shining-man/bsc_extension_serial/README.md

# Serial port extension for the BSC
This extension adds 8 additional serial ports to the Battery safety controller (BSC). This allows a total of 11 serial devices to be connected to the BSC.

The BSC is connected to this extension via an 8-pin bus cable.
