shining-man/bsc_extension_serial/circuit.pdf

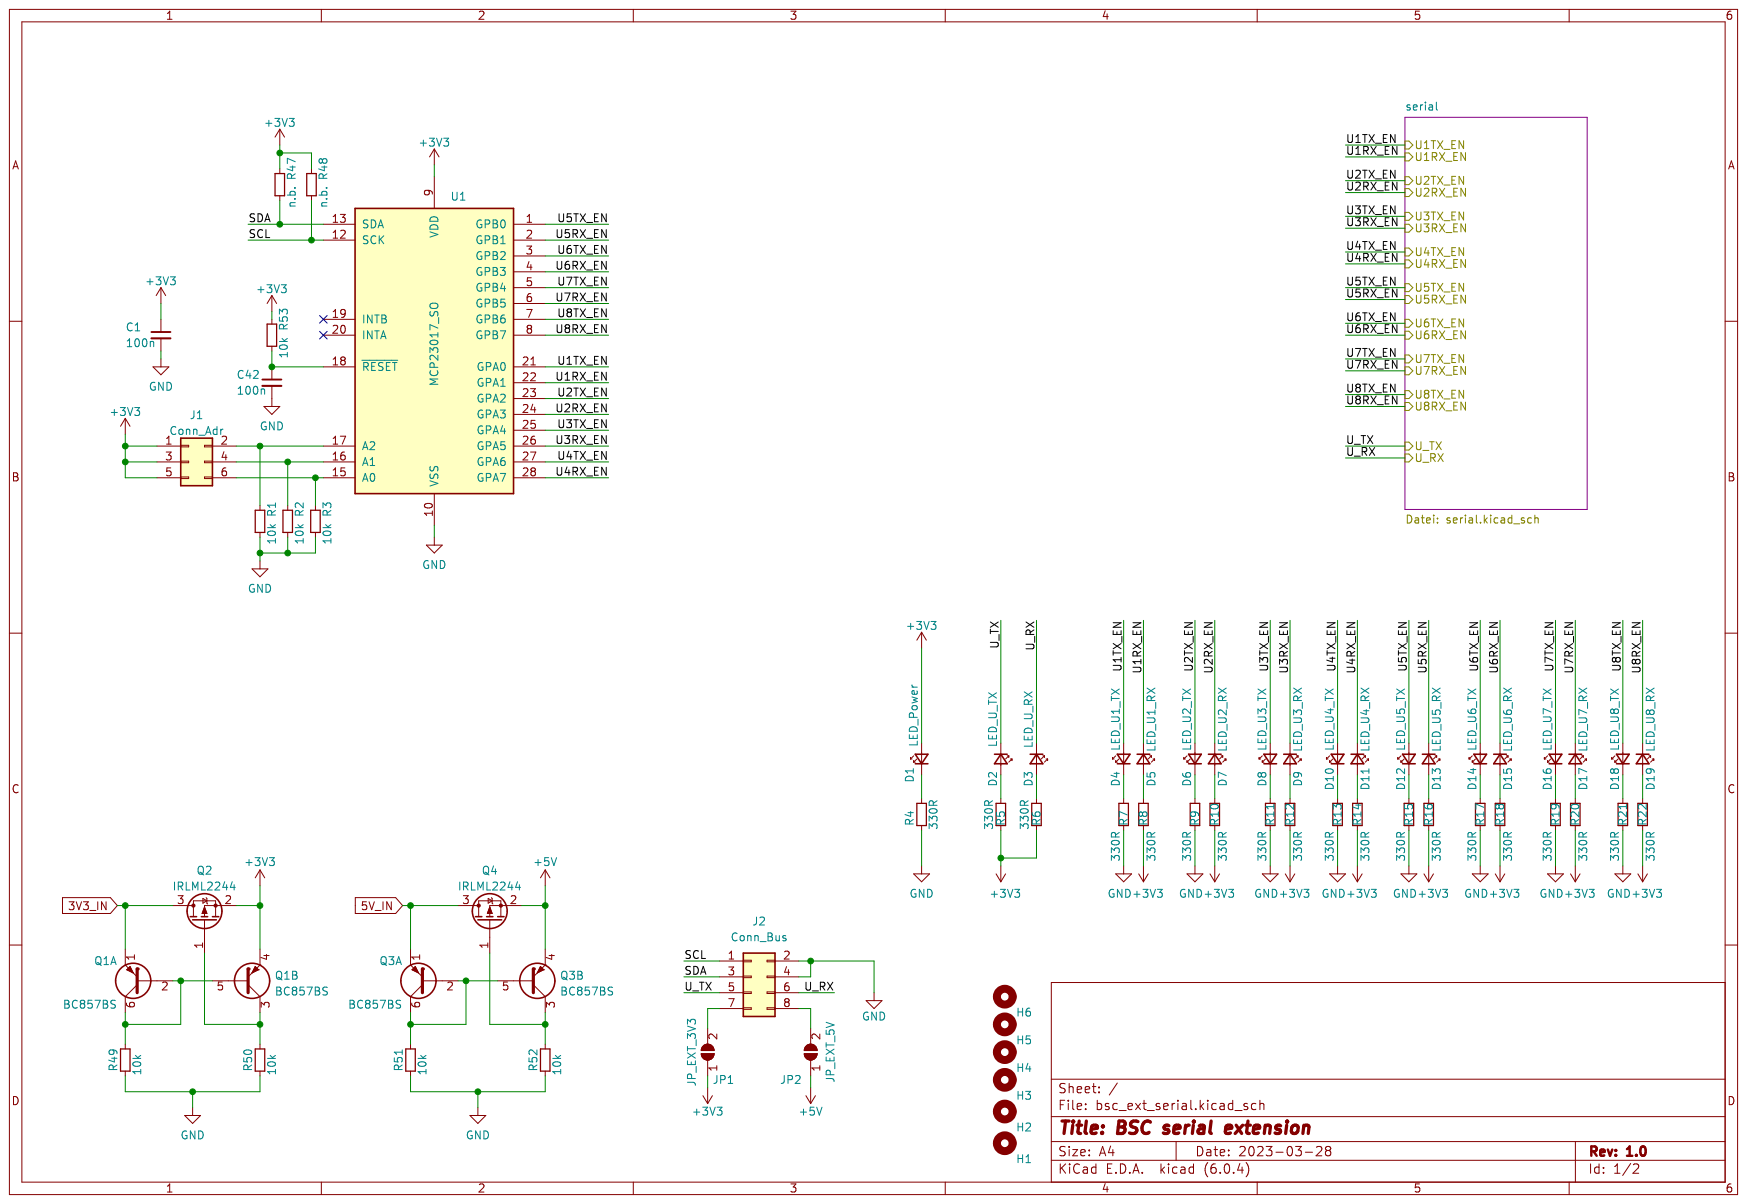
[picture p1: page 1]

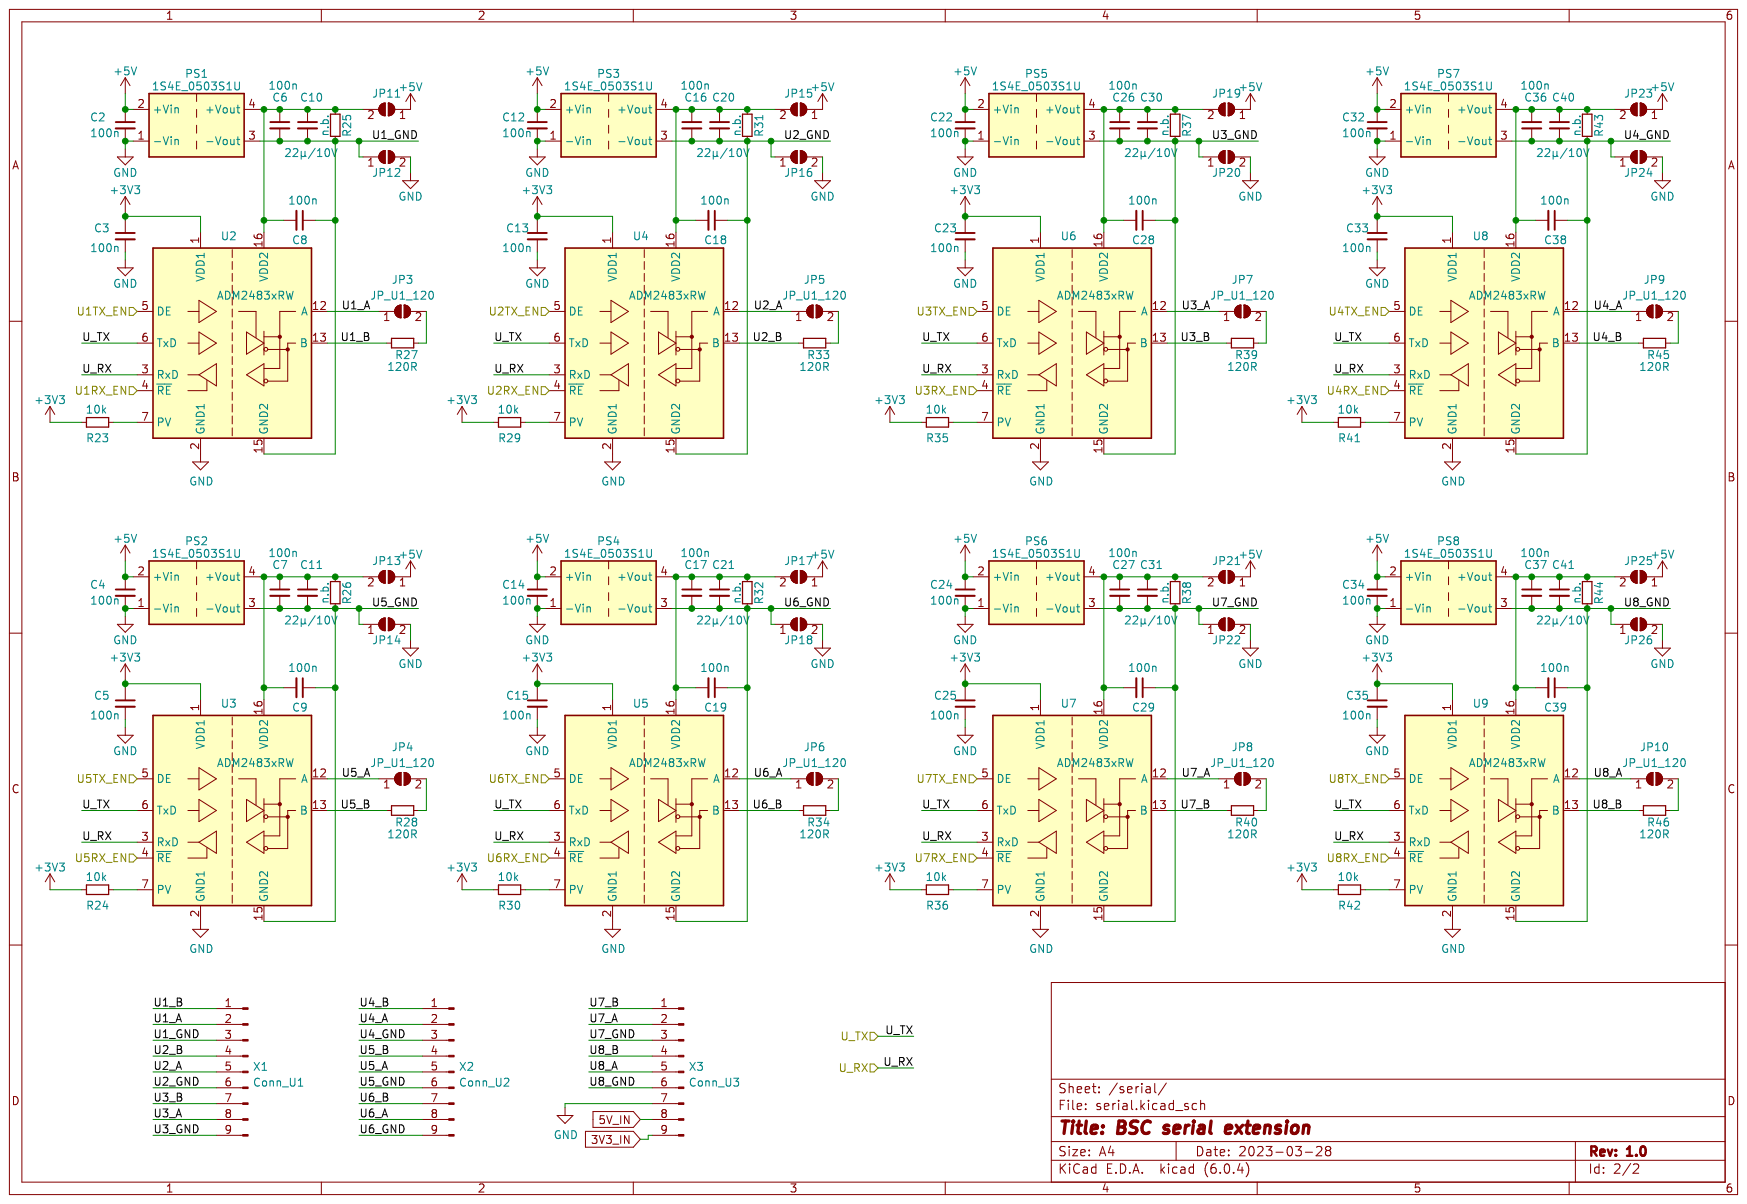
[picture p2: page 2]
