shining-man/bsc_extension_serial/bsc_ext_serial.kicad_pcb

## KiCad design bsc_ext_serial.kicad_pcb (2023-04-03)

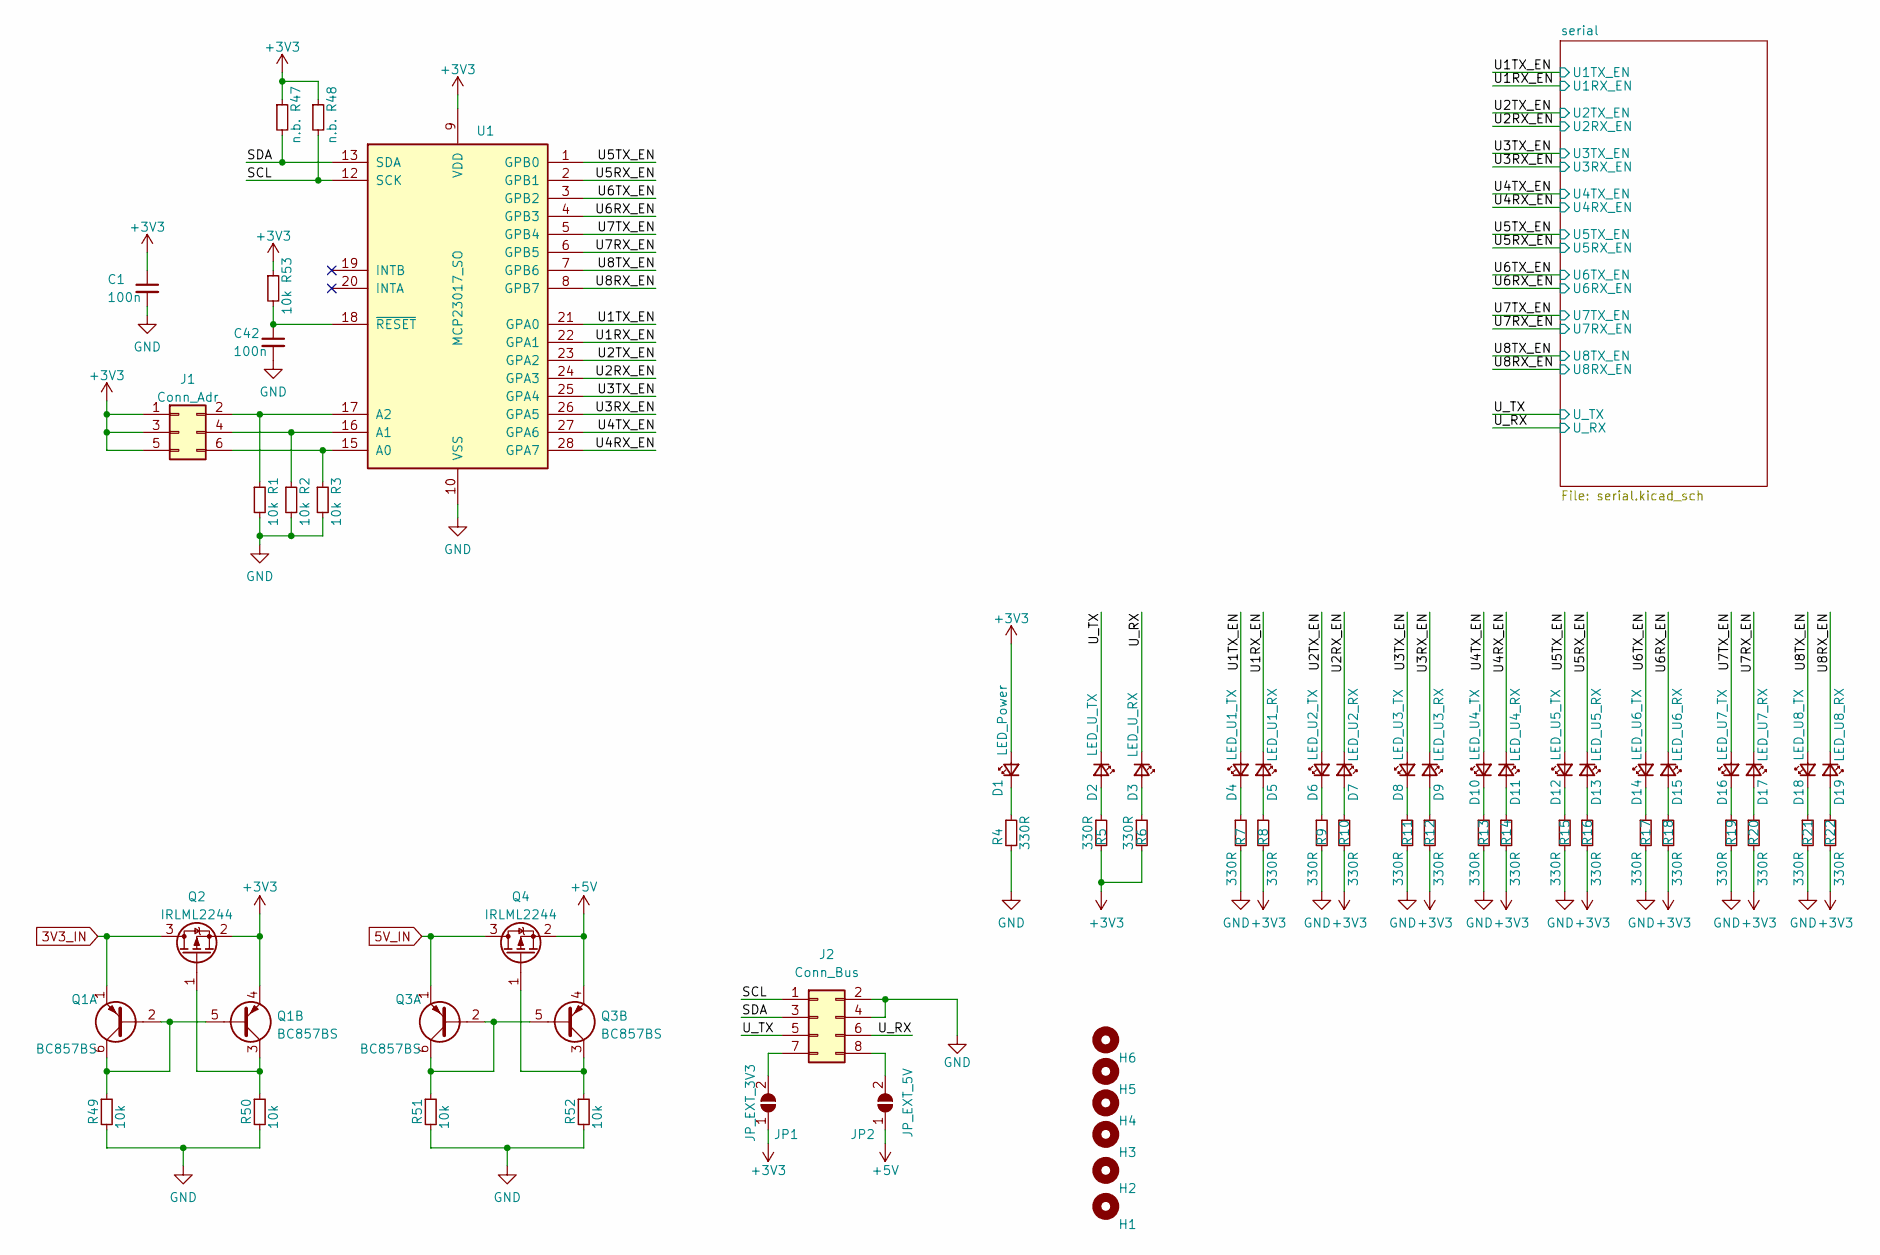
[picture p3: schematic bsc_ext_serial.kicad_sch, BSC serial extension]

Parts:
C1, C42: 100n; C_0603_1608Metric
D1: LED_Power; LED_0603_1608Metric
D2: LED_U_TX; LED_0603_1608Metric
D3: LED_U_RX; LED_0603_1608Metric
D4: LED_U1_TX; LED_0603_1608Metric
D5: LED_U1_RX; LED_0603_1608Metric
D6: LED_U2_TX; LED_0603_1608Metric
D7: LED_U2_RX; LED_0603_1608Metric
D8: LED_U3_TX; LED_0603_1608Metric
D9: LED_U3_RX; LED_0603_1608Metric
D10: LED_U4_TX; LED_0603_1608Metric
D11: LED_U4_RX; LED_0603_1608Metric
D12: LED_U5_TX; LED_0603_1608Metric
D13: LED_U5_RX; LED_0603_1608Metric
D14: LED_U6_TX; LED_0603_1608Metric
D15: LED_U6_RX; LED_0603_1608Metric
D16: LED_U7_TX; LED_0603_1608Metric
D17: LED_U7_RX; LED_0603_1608Metric
D18: LED_U8_TX; LED_0603_1608Metric
D19: LED_U8_RX; LED_0603_1608Metric
H1, H2, H3, H4, H5, H6: MountingHole; MountingHole_3.2mm_M3
J1: Conn_Adr; PinHeader_2x03_P2.54mm_Vertical
J2: Conn_Bus; PinHeader_2x04_P2.54mm_Vertical
JP1: JP_EXT_3V3; SolderJumper-2_P1.3mm_Open_RoundedPad1.0x1.5mm
JP2: JP_EXT_5V; SolderJumper-2_P1.3mm_Open_RoundedPad1.0x1.5mm
Q1, Q3: BC857BS; SOT-363_SC-70-6
Q2, Q4: IRLML2244; SOT-23
R1, R2, R3, R49, R50, R51, R52, R53: 10k; R_0603_1608Metric
R4, R5, R6, R7, R8, R9, R10, R11, R12, R13, R14, R15, R16, R17, R18, R19, R20, R21, R22: 330R; R_0603_1608Metric
R47, R48: n.b.; R_0603_1608Metric
U1: MCP23017_SO; SOIC-28W_7.5x17.9mm_P1.27mm

Connections:
3V3_IN: Q1.1 (E1), Q2.3 (D); also elsewhere on the board
5V_IN: Q3.1 (E1), Q4.3 (D); also elsewhere on the board
+3V3: C1.1, D1.2 (A), J1.1, J1.3, J1.5, JP1.1 (A), Q1.4 (E2), Q2.2 (S), R5.2, R6.2, R8.2, R10.2, R12.2, R14.2, R16.2, R18.2, R20.2, R22.2, R47.1, R48.1, R53.1, U1.9 (VDD); also elsewhere on the board
+5V: JP2.1 (A), Q3.4 (E2), Q4.2 (S); also elsewhere on the board
/SCL: J2.1, R48.2, U1.12 (SCK)
/SDA: J2.3, R47.2, U1.13 (SDA)
/U1RX_EN: D5.1 (K), U1.22 (GPA1); also elsewhere on the board
/U1TX_EN: D4.2 (A), U1.21 (GPA0); also elsewhere on the board
/U2RX_EN: D7.1 (K), U1.24 (GPA3); also elsewhere on the board
/U2TX_EN: D6.2 (A), U1.23 (GPA2); also elsewhere on the board
/U3RX_EN: D9.1 (K), U1.26 (GPA5); also elsewhere on the board
/U3TX_EN: D8.2 (A), U1.25 (GPA4); also elsewhere on the board
/U4RX_EN: D11.1 (K), U1.28 (GPA7); also elsewhere on the board
/U4TX_EN: D10.2 (A), U1.27 (GPA6); also elsewhere on the board
/U5RX_EN: D13.1 (K), U1.2 (GPB1); also elsewhere on the board
/U5TX_EN: D12.2 (A), U1.1 (GPB0); also elsewhere on the board
/U6RX_EN: D15.1 (K), U1.4 (GPB3); also elsewhere on the board
/U6TX_EN: D14.2 (A), U1.3 (GPB2); also elsewhere on the board
/U7RX_EN: D17.1 (K), U1.6 (GPB5); also elsewhere on the board
/U7TX_EN: D16.2 (A), U1.5 (GPB4); also elsewhere on the board
/U8RX_EN: D19.1 (K), U1.8 (GPB7); also elsewhere on the board
/U8TX_EN: D18.2 (A), U1.7 (GPB6); also elsewhere on the board
/U_RX: D3.1 (K), J2.6; also elsewhere on the board
/U_TX: D2.1 (K), J2.5; also elsewhere on the board
GND: C1.2, C42.2, J2.2, J2.4, R1.2, R2.2, R3.2, R4.2, R7.2, R9.2, R11.2, R13.2, R15.2, R17.2, R19.2, R21.2, R49.2, R50.2, R51.2, R52.2, U1.10 (VSS); also elsewhere on the board
unnamed: C42.1, R53.2, U1.18 (~RESET)
unnamed: D1.1 (K), R4.1
unnamed: D2.2 (A), R5.1
unnamed: D3.2 (A), R6.1
unnamed: D4.1 (K), R7.1
unnamed: D5.2 (A), R8.1
unnamed: D6.1 (K), R9.1
unnamed: D7.2 (A), R10.1
unnamed: D8.1 (K), R11.1
unnamed: D9.2 (A), R12.1
unnamed: D10.1 (K), R13.1
unnamed: D11.2 (A), R14.1
unnamed: D12.1 (K), R15.1
unnamed: D13.2 (A), R16.1
unnamed: D14.1 (K), R17.1
unnamed: D15.2 (A), R18.1
unnamed: D16.1 (K), R19.1
unnamed: D17.2 (A), R20.1
unnamed: D18.1 (K), R21.1
unnamed: D19.2 (A), R22.1
unnamed: J1.2, R1.1, U1.17 (A2)
unnamed: J1.4, R2.1, U1.16 (A1)
unnamed: J1.6, R3.1, U1.15 (A0)
unnamed: J2.7, JP1.2 (B)
unnamed: J2.8, JP2.2 (B)
unnamed: Q1.2 (B1), Q1.5 (B2), Q1.6 (C1), R49.1
unnamed: Q1.3 (C2), Q2.1 (G), R50.1
unnamed: Q3.2 (B1), Q3.5 (B2), Q3.6 (C1), R51.1
unnamed: Q3.3 (C2), Q4.1 (G), R52.1

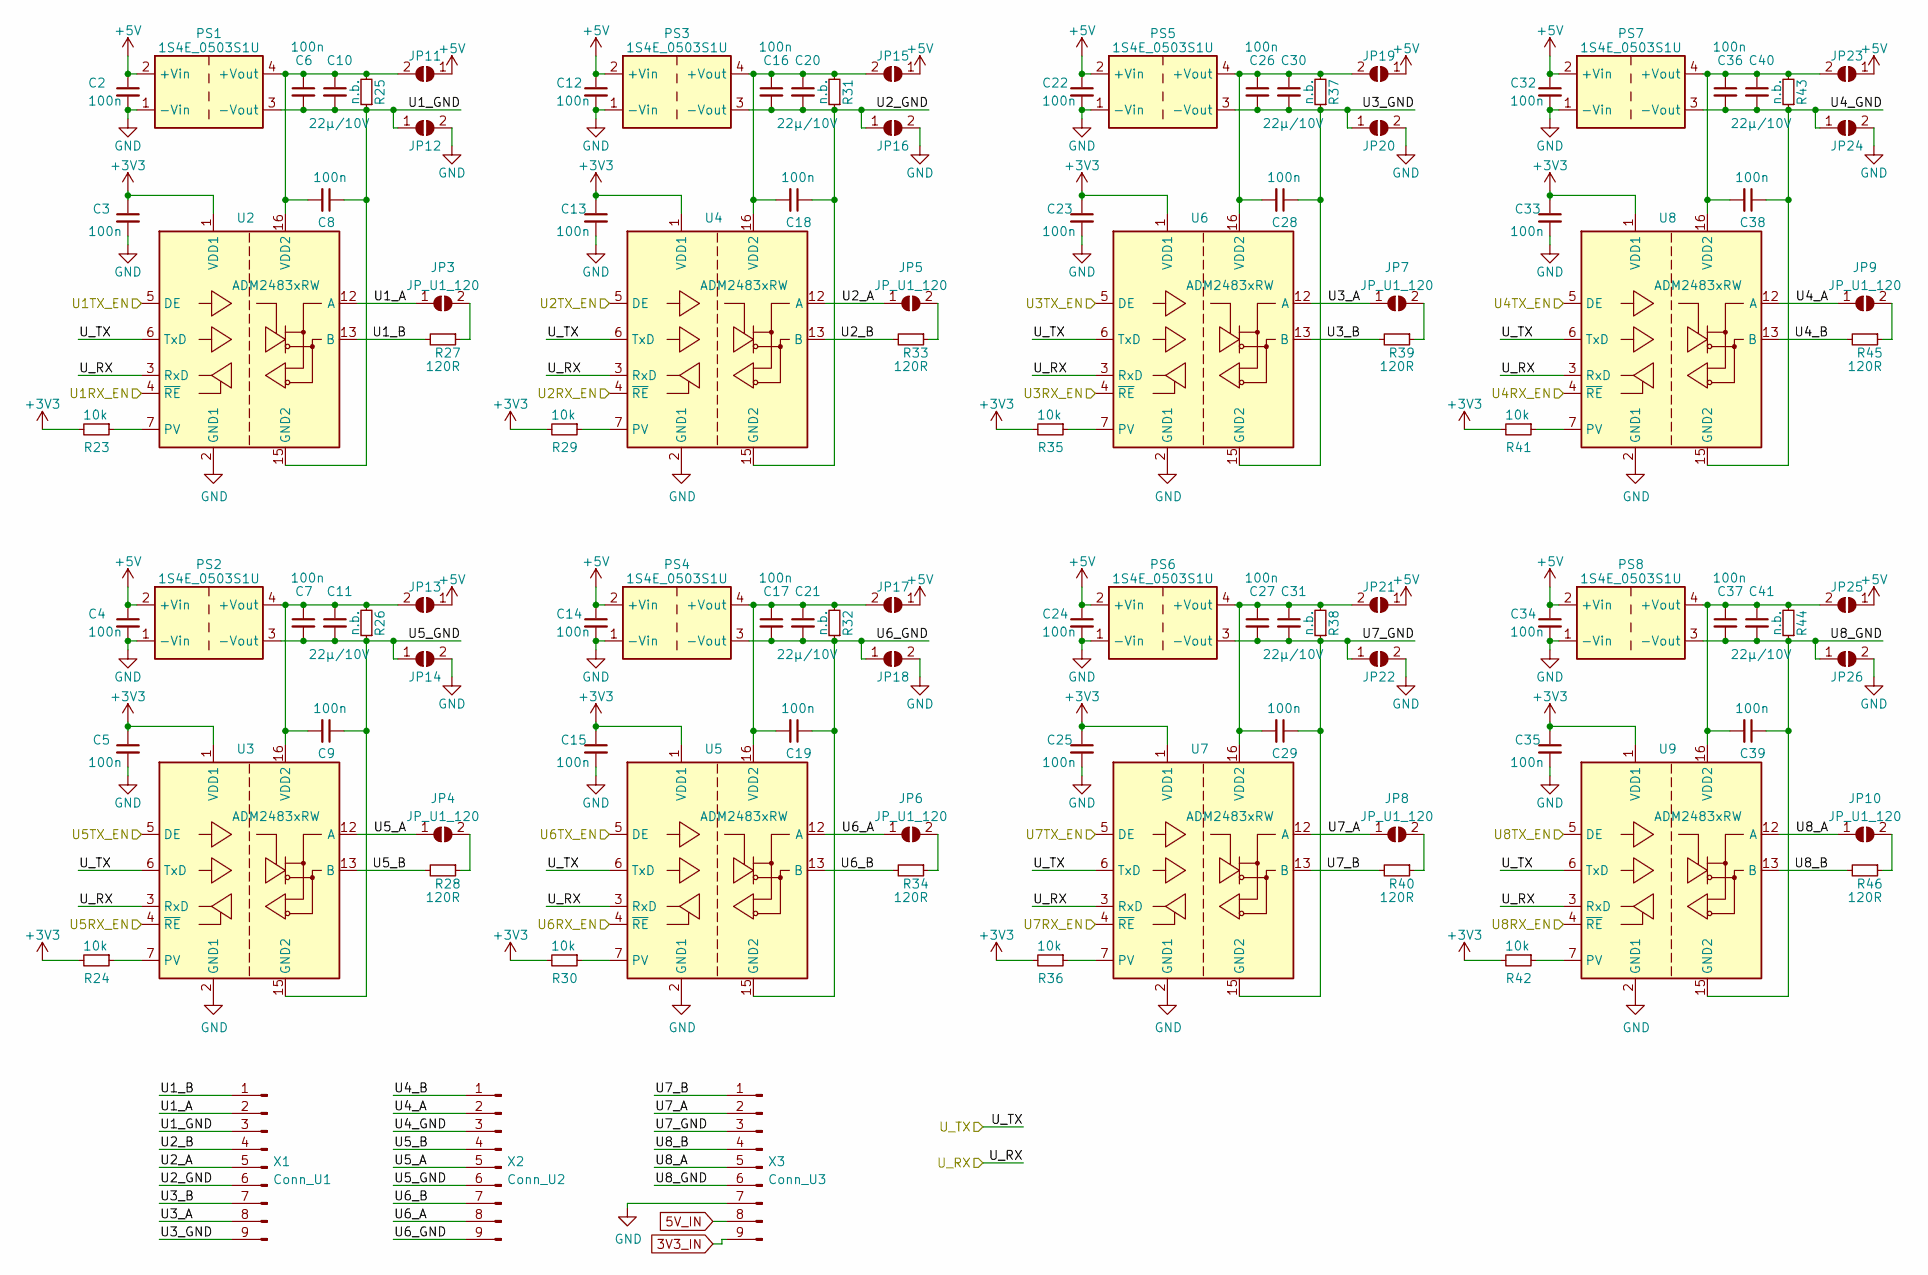
[picture p4: schematic serial.kicad_sch, BSC serial extension]

Parts:
C2, C3, C4, C5, C6, C7, C8, C9, C12, C13, C14, C15, C16, C17, C18, C19, C22, C23, C24, C25, C26, C27, C28, C29, C32, C33, C34, C35, C36, C37, C38, C39: 100n; C_0603_1608Metric
C10, C11, C20, C21, C30, C31, C40, C41: 22µ/10V; C_1206_3216Metric
JP3, JP4, JP5, JP6, JP7, JP8, JP9, JP10: JP_U1_120; SolderJumper-2_P1.3mm_Open_Pad1.0x1.5mm
JP11, JP12, JP13, JP14, JP15, JP16, JP17, JP18, JP19, JP20, JP21, JP22, JP23, JP24, JP25, JP26: SolderJumper-2_P1.3mm_Open_RoundedPad1.0x1.5mm
PS1, PS2, PS3, PS4, PS5, PS6, PS7, PS8: 1S4E_0503S1U; Converter_DCDC_GAPTEC_1S4E_S1U
R23, R24, R29, R30, R35, R36, R41, R42: 10k; R_0603_1608Metric
R25, R26, R31, R32, R37, R38, R43, R44: n.b.; R_0603_1608Metric
R27, R28, R33, R34, R39, R40, R45, R46: 120R; R_0603_1608Metric
U2, U3, U4, U5, U6, U7, U8, U9: ADM2483xRW; SOIC-16W_7.5x10.3mm_P1.27mm; PartNumber ADM2483BRWZ-REEL; LCSCStockCode C9637
X1: Conn_U1; PhoenixContact_MCV_1,5_9-G-3.81_1x09_P3.81mm_Vertical
X2: Conn_U2; PhoenixContact_MCV_1,5_9-G-3.81_1x09_P3.81mm_Vertical
X3: Conn_U3; PhoenixContact_MCV_1,5_9-G-3.81_1x09_P3.81mm_Vertical

Connections:
3V3_IN: X3.9; also elsewhere on the board
5V_IN: X3.8; also elsewhere on the board
+3V3: C3.1, C5.1, C13.1, C15.1, C23.1, C25.1, C33.1, C35.1, R23.2, R24.2, R29.2, R30.2, R35.2, R36.2, R41.2, R42.2, U2.1 (VDD1), U3.1 (VDD1), U4.1 (VDD1), U5.1 (VDD1), U6.1 (VDD1), U7.1 (VDD1), U8.1 (VDD1), U9.1 (VDD1); also elsewhere on the board
+5V: C2.1, C4.1, C12.1, C14.1, C22.1, C24.1, C32.1, C34.1, JP11.1 (A), JP13.1 (A), JP15.1 (A), JP17.1 (A), JP19.1 (A), JP21.1 (A), JP23.1 (A), JP25.1 (A), PS1.2 (+Vin), PS2.2 (+Vin), PS3.2 (+Vin), PS4.2 (+Vin), PS5.2 (+Vin), PS6.2 (+Vin), PS7.2 (+Vin), PS8.2 (+Vin); also elsewhere on the board
/U1RX_EN: U2.4 (~RE); also elsewhere on the board
/U1TX_EN: U2.5 (DE); also elsewhere on the board
/U2RX_EN: U4.4 (~RE); also elsewhere on the board
/U2TX_EN: U4.5 (DE); also elsewhere on the board
/U3RX_EN: U6.4 (~RE); also elsewhere on the board
/U3TX_EN: U6.5 (DE); also elsewhere on the board
/U4RX_EN: U8.4 (~RE); also elsewhere on the board
/U4TX_EN: U8.5 (DE); also elsewhere on the board
/U5RX_EN: U3.4 (~RE); also elsewhere on the board
/U5TX_EN: U3.5 (DE); also elsewhere on the board
/U6RX_EN: U5.4 (~RE); also elsewhere on the board
/U6TX_EN: U5.5 (DE); also elsewhere on the board
/U7RX_EN: U7.4 (~RE); also elsewhere on the board
/U7TX_EN: U7.5 (DE); also elsewhere on the board
/U8RX_EN: U9.4 (~RE); also elsewhere on the board
/U8TX_EN: U9.5 (DE); also elsewhere on the board
/U_RX: U2.3 (RxD), U3.3 (RxD), U4.3 (RxD), U5.3 (RxD), U6.3 (RxD), U7.3 (RxD), U8.3 (RxD), U9.3 (RxD); also elsewhere on the board
/U_TX: U2.6 (TxD), U3.6 (TxD), U4.6 (TxD), U5.6 (TxD), U6.6 (TxD), U7.6 (TxD), U8.6 (TxD), U9.6 (TxD); also elsewhere on the board
/serial/U1_A: JP3.1 (A), U2.12 (A), X1.2
/serial/U1_B: R27.2, U2.13 (B), X1.1
/serial/U1_GND: C6.2, C8.1, C10.2, JP12.1 (A), PS1.3 (-Vout), R25.1, U2.9 (GND2), U2.15 (GND2), X1.3
/serial/U2_A: JP5.1 (A), U4.12 (A), X1.5
/serial/U2_B: R33.2, U4.13 (B), X1.4
/serial/U2_GND: C16.2, C18.1, C20.2, JP16.1 (A), PS3.3 (-Vout), R31.1, U4.9 (GND2), U4.15 (GND2), X1.6
/serial/U3_A: JP7.1 (A), U6.12 (A), X1.8
/serial/U3_B: R39.2, U6.13 (B), X1.7
/serial/U3_GND: C26.2, C28.1, C30.2, JP20.1 (A), PS5.3 (-Vout), R37.1, U6.9 (GND2), U6.15 (GND2), X1.9
/serial/U4_A: JP9.1 (A), U8.12 (A), X2.2
/serial/U4_B: R45.2, U8.13 (B), X2.1
/serial/U4_GND: C36.2, C38.1, C40.2, JP24.1 (A), PS7.3 (-Vout), R43.1, U8.9 (GND2), U8.15 (GND2), X2.3
/serial/U5_A: JP4.1 (A), U3.12 (A), X2.5
/serial/U5_B: R28.2, U3.13 (B), X2.4
/serial/U5_GND: C7.2, C9.1, C11.2, JP14.1 (A), PS2.3 (-Vout), R26.1, U3.9 (GND2), U3.15 (GND2), X2.6
/serial/U6_A: JP6.1 (A), U5.12 (A), X2.8
/serial/U6_B: R34.2, U5.13 (B), X2.7
/serial/U6_GND: C17.2, C19.1, C21.2, JP18.1 (A), PS4.3 (-Vout), R32.1, U5.9 (GND2), U5.15 (GND2), X2.9
/serial/U7_A: JP8.1 (A), U7.12 (A), X3.2
/serial/U7_B: R40.2, U7.13 (B), X3.1
/serial/U7_GND: C27.2, C29.1, C31.2, JP22.1 (A), PS6.3 (-Vout), R38.1, U7.9 (GND2), U7.15 (GND2), X3.3
/serial/U8_A: JP10.1 (A), U9.12 (A), X3.5
/serial/U8_B: R46.2, U9.13 (B), X3.4
/serial/U8_GND: C37.2, C39.1, C41.2, JP26.1 (A), PS8.3 (-Vout), R44.1, U9.9 (GND2), U9.15 (GND2), X3.6
GND: C2.2, C3.2, C4.2, C5.2, C12.2, C13.2, C14.2, C15.2, C22.2, C23.2, C24.2, C25.2, C32.2, C33.2, C34.2, C35.2, JP12.2 (B), JP14.2 (B), JP16.2 (B), JP18.2 (B), JP20.2 (B), JP22.2 (B), JP24.2 (B), JP26.2 (B), PS1.1 (-Vin), PS2.1 (-Vin), PS3.1 (-Vin), PS4.1 (-Vin), PS5.1 (-Vin), PS6.1 (-Vin), PS7.1 (-Vin), PS8.1 (-Vin), U2.2 (GND1), U2.8 (GND1), U3.2 (GND1), U3.8 (GND1), U4.2 (GND1), U4.8 (GND1), U5.2 (GND1), U5.8 (GND1), U6.2 (GND1), U6.8 (GND1), U7.2 (GND1), U7.8 (GND1), U8.2 (GND1), U8.8 (GND1), U9.2 (GND1), U9.8 (GND1), X3.7; also elsewhere on the board
unnamed: C6.1, C8.2, C10.1, JP11.2 (B), PS1.4 (+Vout), R25.2, U2.16 (VDD2)
unnamed: C7.1, C9.2, C11.1, JP13.2 (B), PS2.4 (+Vout), R26.2, U3.16 (VDD2)
unnamed: C16.1, C18.2, C20.1, JP15.2 (B), PS3.4 (+Vout), R31.2, U4.16 (VDD2)
unnamed: C17.1, C19.2, C21.1, JP17.2 (B), PS4.4 (+Vout), R32.2, U5.16 (VDD2)
unnamed: C26.1, C28.2, C30.1, JP19.2 (B), PS5.4 (+Vout), R37.2, U6.16 (VDD2)
unnamed: C27.1, C29.2, C31.1, JP21.2 (B), PS6.4 (+Vout), R38.2, U7.16 (VDD2)
unnamed: C36.1, C38.2, C40.1, JP23.2 (B), PS7.4 (+Vout), R43.2, U8.16 (VDD2)
unnamed: C37.1, C39.2, C41.1, JP25.2 (B), PS8.4 (+Vout), R44.2, U9.16 (VDD2)
unnamed: JP3.2 (B), R27.1
unnamed: JP4.2 (B), R28.1
unnamed: JP5.2 (B), R33.1
unnamed: JP6.2 (B), R34.1
unnamed: JP7.2 (B), R39.1
unnamed: JP8.2 (B), R40.1
unnamed: JP9.2 (B), R45.1
unnamed: JP10.2 (B), R46.1
unnamed: R23.1, U2.7 (PV)
unnamed: R24.1, U3.7 (PV)
unnamed: R29.1, U4.7 (PV)
unnamed: R30.1, U5.7 (PV)
unnamed: R35.1, U6.7 (PV)
unnamed: R36.1, U7.7 (PV)
unnamed: R41.1, U8.7 (PV)
unnamed: R42.1, U9.7 (PV)

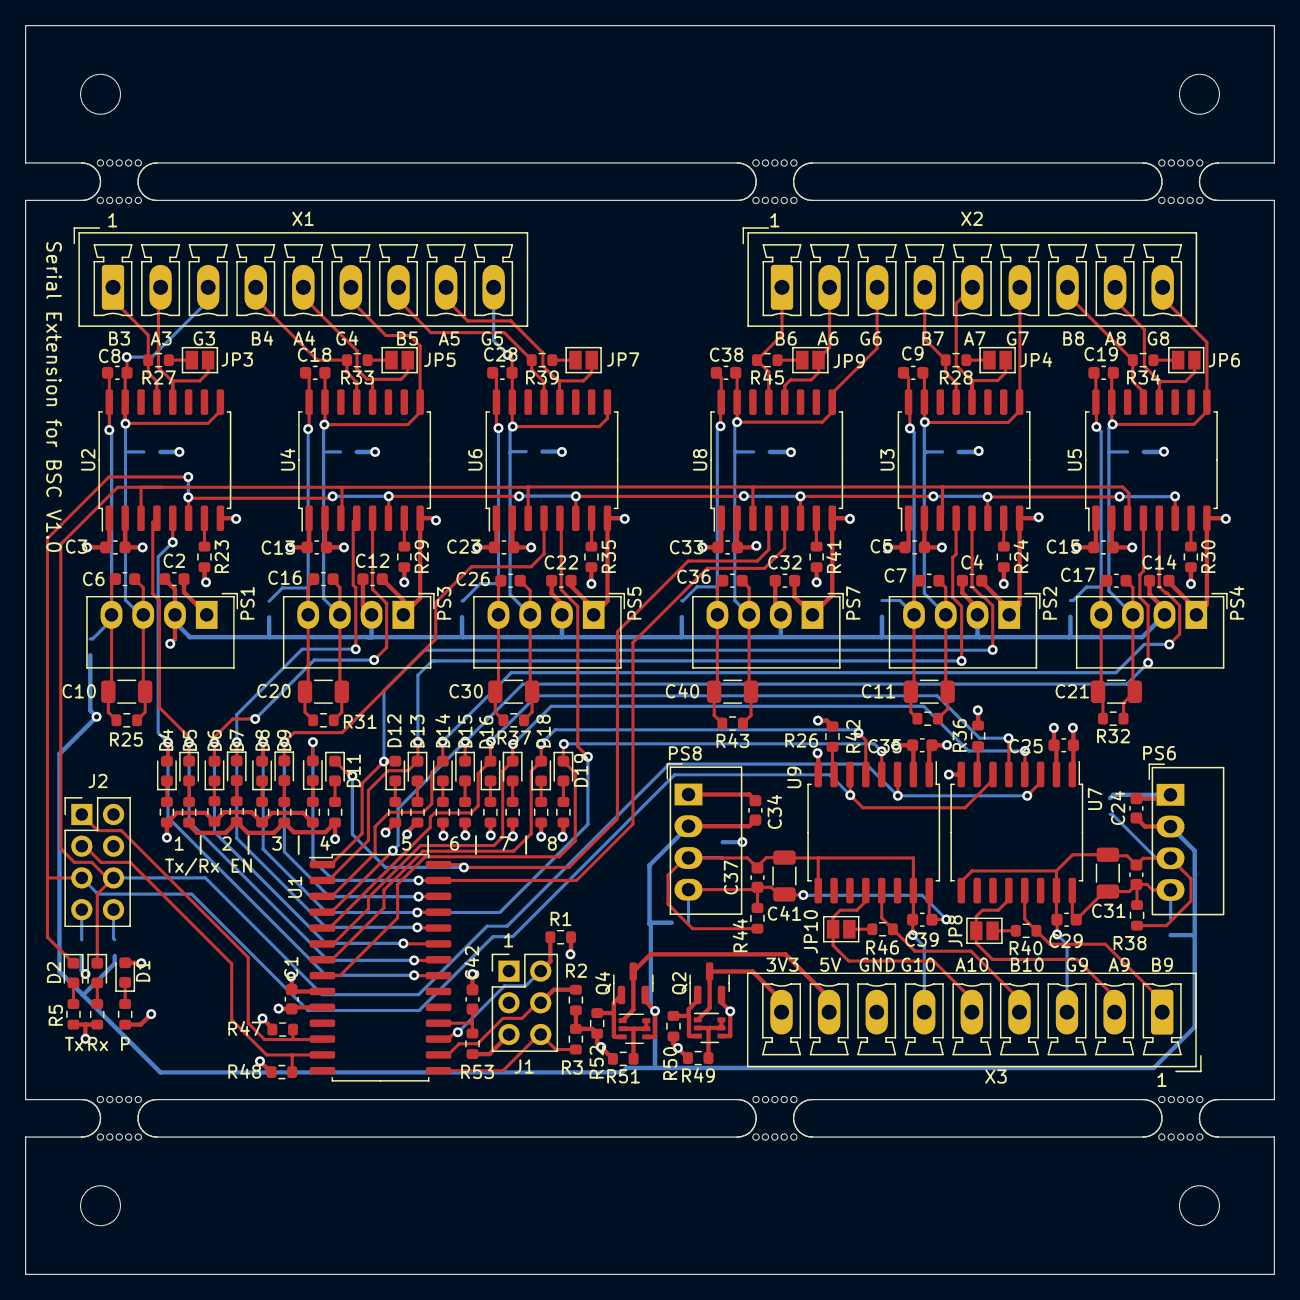
[picture p5: board bsc_ext_serial.kicad_pcb from above]

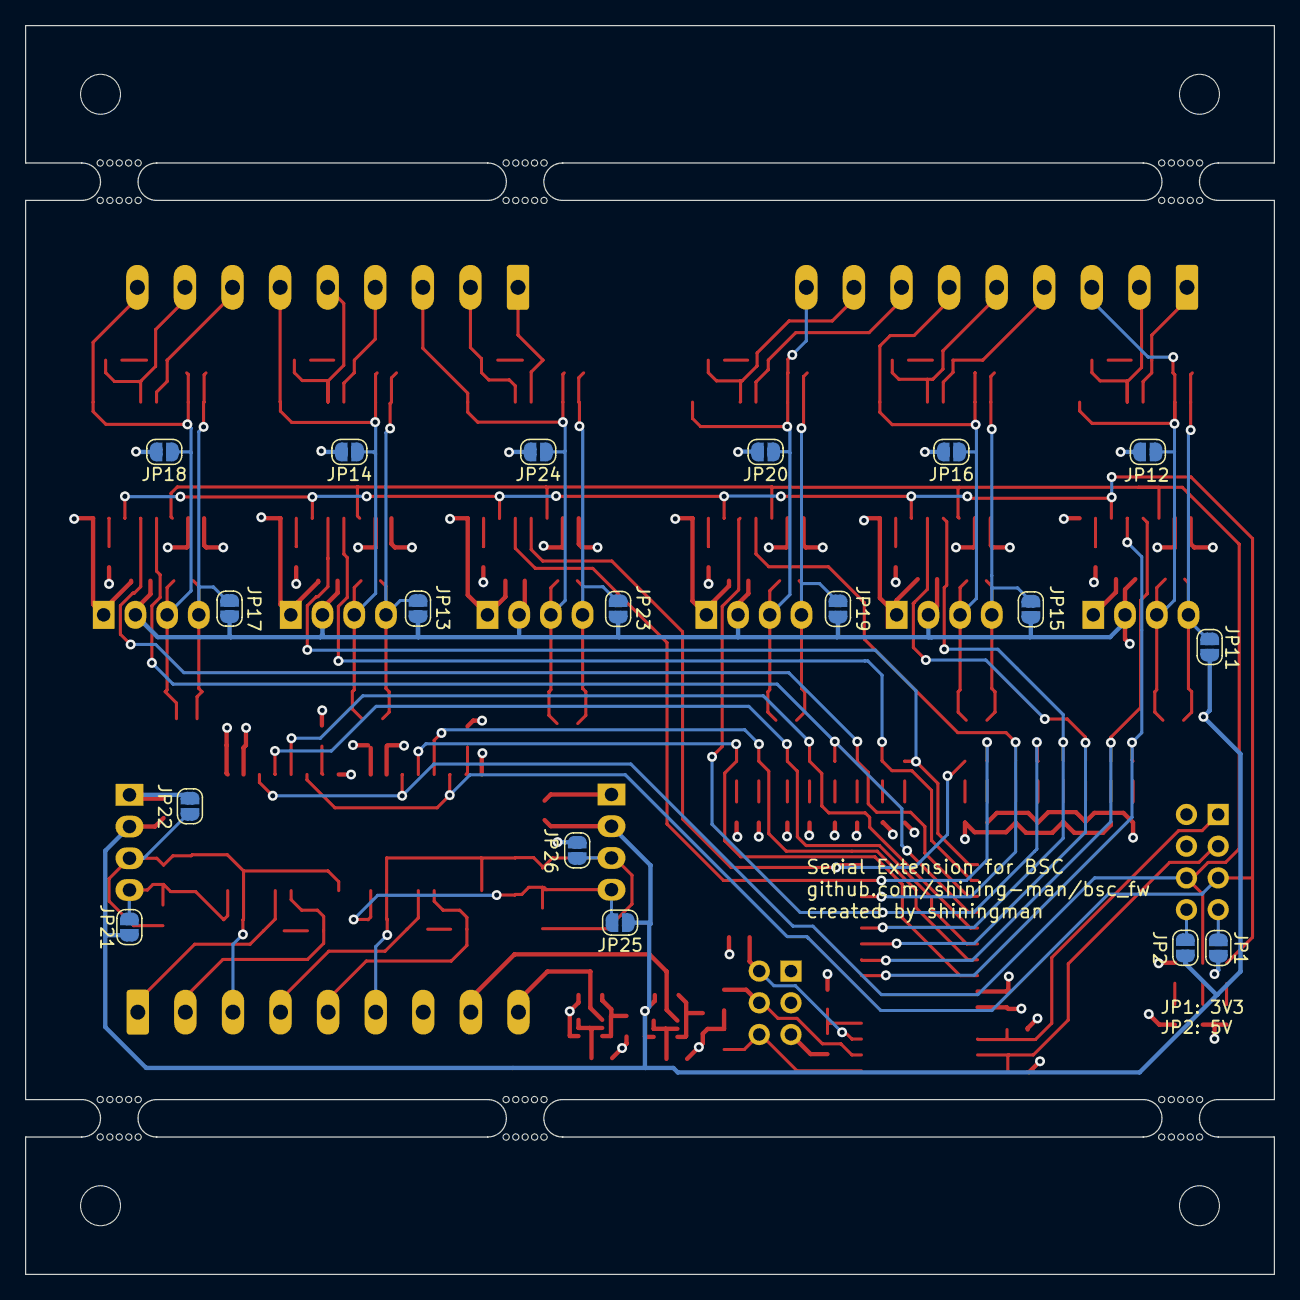
[picture p6: board bsc_ext_serial.kicad_pcb from below]

Board: 4 copper layers, 100.0 x 100.0 mm, 176 parts (18 on the bottom side), 102 nets.

Other parts of the board:
mouse-bite-3mm-slot_1, mouse-bite-3mm-slot_2, mouse-bite-3mm-slot_3, mouse-bite-3mm-slot_4, mouse-bite-3mm-slot_5, mouse-bite-3mm-slot_6: VAL**; mouse-bite-3mm-slot
