shining-man/bsc_extension_serial/(threads)

Thread 1 (2024-08-25):

Extension Board - where to buy?

haselnuss1971, 2024-08-25:
Hi all,

i have founf the Master Board by Ali Express.
But i dont find the extension board.

Can anybody send me a link?

THX and st Jürgen

tueftler0, 2024-08-26:
Currently the expansion board is temporary out of sale.
I still have a single board that is for sale. It is a new one that has never been used.
If you are interested in it, please contact me via PM on the Discord server, thank you.
