shining-man/bsc_extension_serial/(commit log)

2023-04-01 First revision
    [bsc_ext_serial.kicad_pcb, bsc_ext_serial.kicad_sch, serial.kicad_sch]
2023-04-03 modify J2 position
    [bsc_ext_serial.kicad_pcb, bsc_ext_serial.kicad_sch, serial.kicad_sch]
